clucasjiang/dexter_v1/(list of files, cad)

Other CAD files:
CAD/DexterAssembly.STEP
