clucasjiang/dexter_v1/PCB/main_controller/dexter_pcb.kicad_pcb

## KiCad design PCB/main_controller/dexter_pcb.kicad_pcb (2026-09-09)

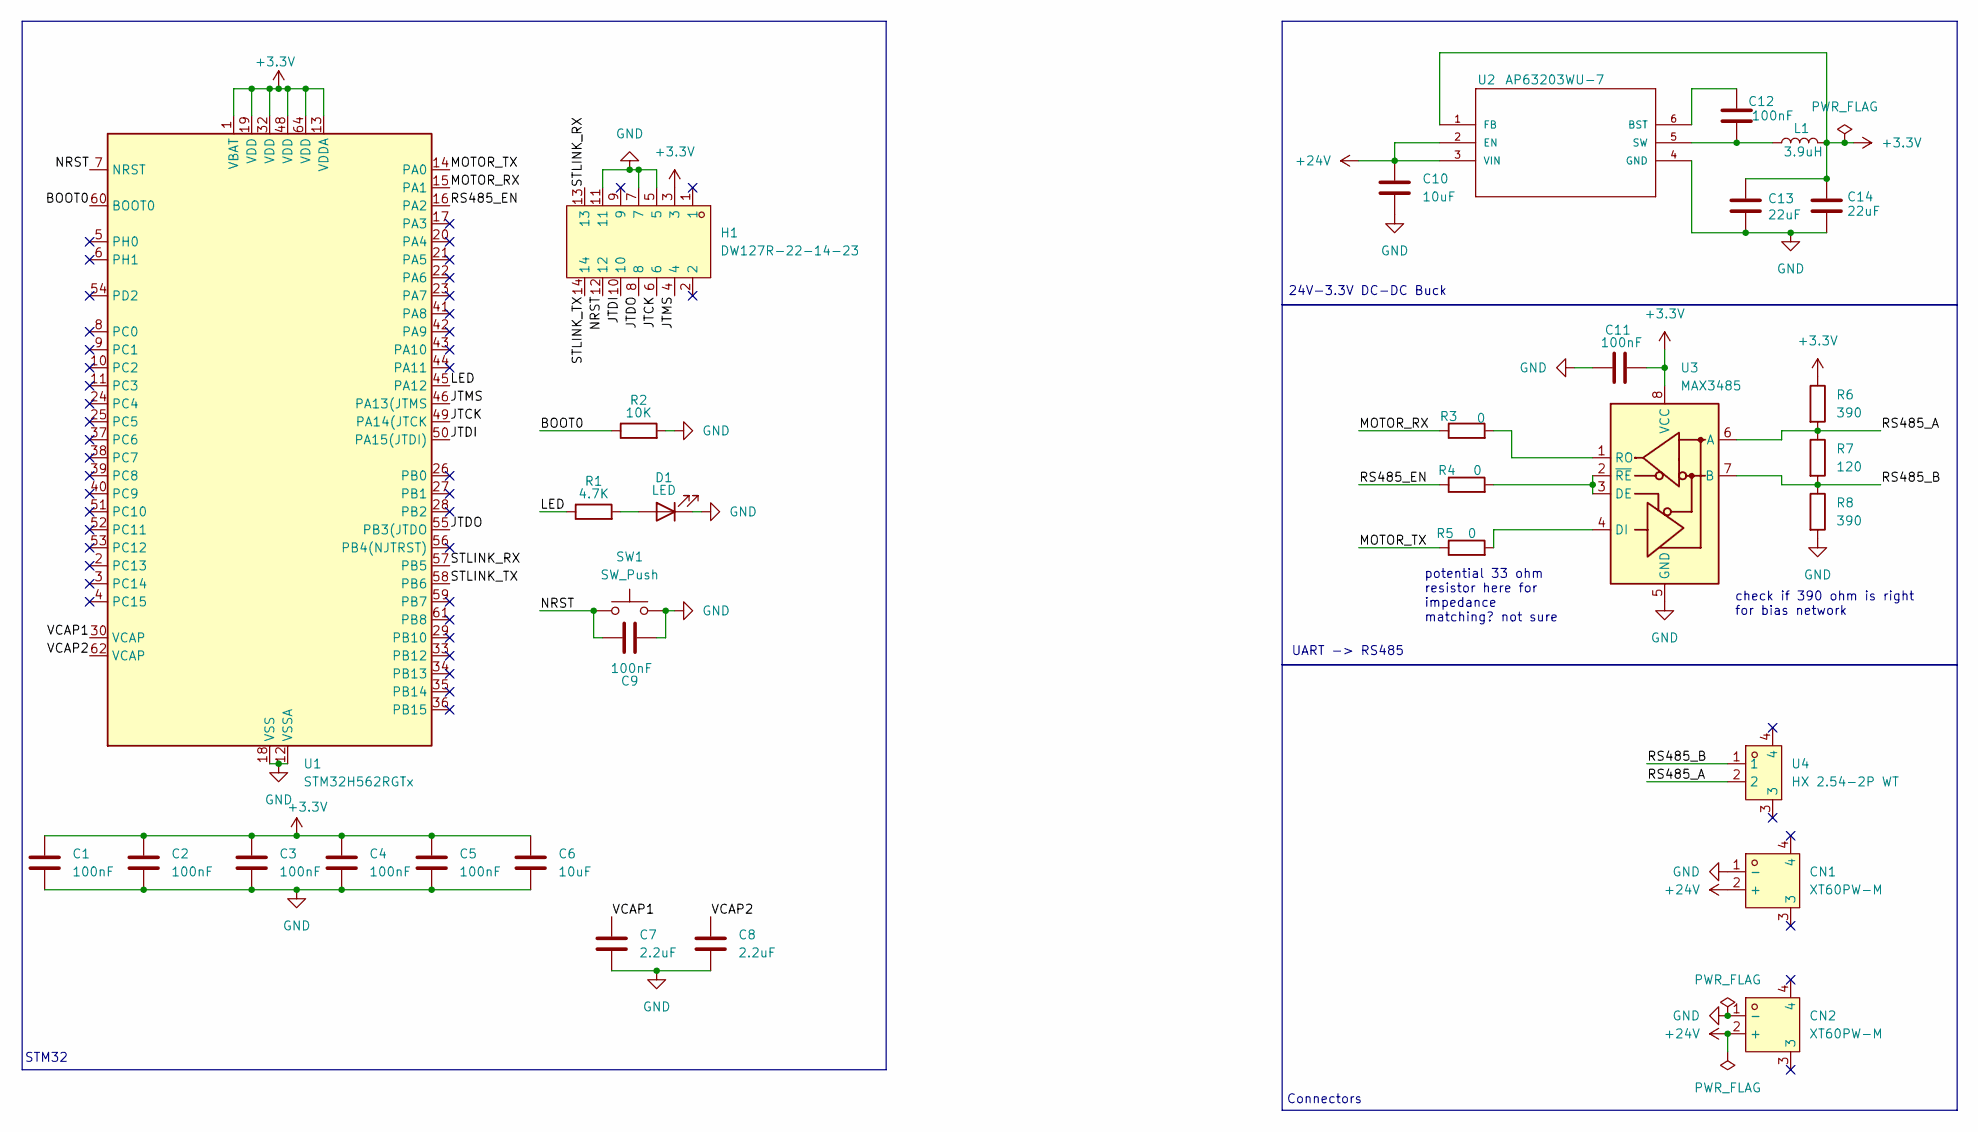
[picture p5: schematic dexter_pcb.kicad_sch, Dexter Main Controller]

Parts:
C1, C2, C3, C4, C5, C9, C11, C12: 100nF; C_0603_1608Metric_Pad1.08x0.95mm_HandSolder
C6, C10: 10uF; C_0603_1608Metric_Pad1.08x0.95mm_HandSolder
C7, C8: 2.2uF; C_0603_1608Metric_Pad1.08x0.95mm_HandSolder
C13, C14: 22uF; C_0603_1608Metric_Pad1.08x0.95mm_HandSolder
CN1, CN2: XT60PW-M; CONN-TH_XT60PW-M; MPN XT60PW-M; LCSC Part C98732
D1: LED; LED_0603_1608Metric_Pad1.05x0.95mm_HandSolder
H1: DW127R-22-14-23; HDR-TH_14P-P1.27-V-M-R2-C7-S1.27-2; MPN DW127R-22-14-23; LCSC Part C2935955
L1: 3.9uH; L_Changjiang_FNR4030S; LCSC C167872
R1: 4.7K; R_0603_1608Metric_Pad0.98x0.95mm_HandSolder
R2: 10K; R_0603_1608Metric_Pad0.98x0.95mm_HandSolder
R3, R4, R5: 0; R_0603_1608Metric_Pad0.98x0.95mm_HandSolder
R6, R8: 390; R_0603_1608Metric_Pad0.98x0.95mm_HandSolder
R7: 120; R_0603_1608Metric_Pad0.98x0.95mm_HandSolder
SW1: SW_Push; SW_SPST_TS-1088-xR020; LCSC C720477
U1: STM32H562RGTx; LQFP-64_10x10mm_P0.5mm; LCSC C19711662
U2: AP63203WU-7; TSOT-23-6_HandSoldering; MPN AP63203WU-7; LCSC C780769
U3: MAX3485; SOIC-8_3.9x4.9mm_P1.27mm; LCSC C9943
U4: HX 2.54-2P WT; CONN-SMD_2P-P2.54-XH2.54-WT; MPN HX 2.54-2P WT; LCSC Part C5142098

Connections:
+3.3V: C1.1, C2.1, C3.1, C4.1, C5.1, C6.1, C11.2, C13.1, C14.1, H1.3, L1.2, R6.1, U1.1 (VBAT), U1.13 (VDDA), U1.19 (VDD), U1.32 (VDD), U1.48 (VDD), U1.64 (VDD), U2.1 (FB), U3.8 (VCC)
+24V: C10.1, CN1.2 (+), CN2.2 (+), U2.2 (EN), U2.3 (VIN)
/BOOT0: R2.1, U1.60 (BOOT0)
/JTCK: H1.6, U1.49 (PA14(JTCK)
/JTDI: H1.10, U1.50 (PA15(JTDI))
/JTDO: H1.8, U1.55 (PB3(JTDO)
/JTMS: H1.4, U1.46 (PA13(JTMS)
/LED: R1.1, U1.45 (PA12)
/MOTOR_RX: R3.1, U1.15 (PA1)
/MOTOR_TX: R5.1, U1.14 (PA0)
/NRST: C9.1, H1.12, SW1.1, U1.7 (NRST)
/RS485_A: R6.2, R7.1, U3.6 (A), U4.2
/RS485_B: R7.2, R8.1, U3.7 (B), U4.1
/RS485_EN: R4.1, U1.16 (PA2)
/STLINK_RX: H1.13, U1.57 (PB5)
/STLINK_TX: H1.14, U1.58 (PB6)
/VCAP1: C7.1, U1.30 (VCAP)
/VCAP2: C8.1, U1.62 (VCAP)
GND: C1.2, C2.2, C3.2, C4.2, C5.2, C6.2, C7.2, C8.2, C9.2, C10.2, C11.1, C13.2, C14.2, CN1.1 (-), CN2.1 (-), D1.1 (K), H1.5, H1.7, H1.11, R2.2, R8.2, SW1.2, U1.12 (VSSA), U1.18 (VSS), U1.31 (VSS), U1.47 (VSS), U1.63 (VSS), U2.4 (GND), U3.5 (GND)
unnamed: D1.2 (A), R1.2
unnamed: C12.1, U2.6 (BST)
unnamed: C12.2, L1.1, U2.5 (SW)
unnamed: R4.2, U3.2 (~RE), U3.3 (DE)
unnamed: R5.2, U3.4 (DI)
unnamed: R3.2, U3.1 (RO)

Notes on the sheet:
UART -> RS485
24V-3.3V DC-DC Buck
STM32
Connectors
check if 390 ohm is right for bias network
potential 33 ohm resistor here for impedance matching? not sure

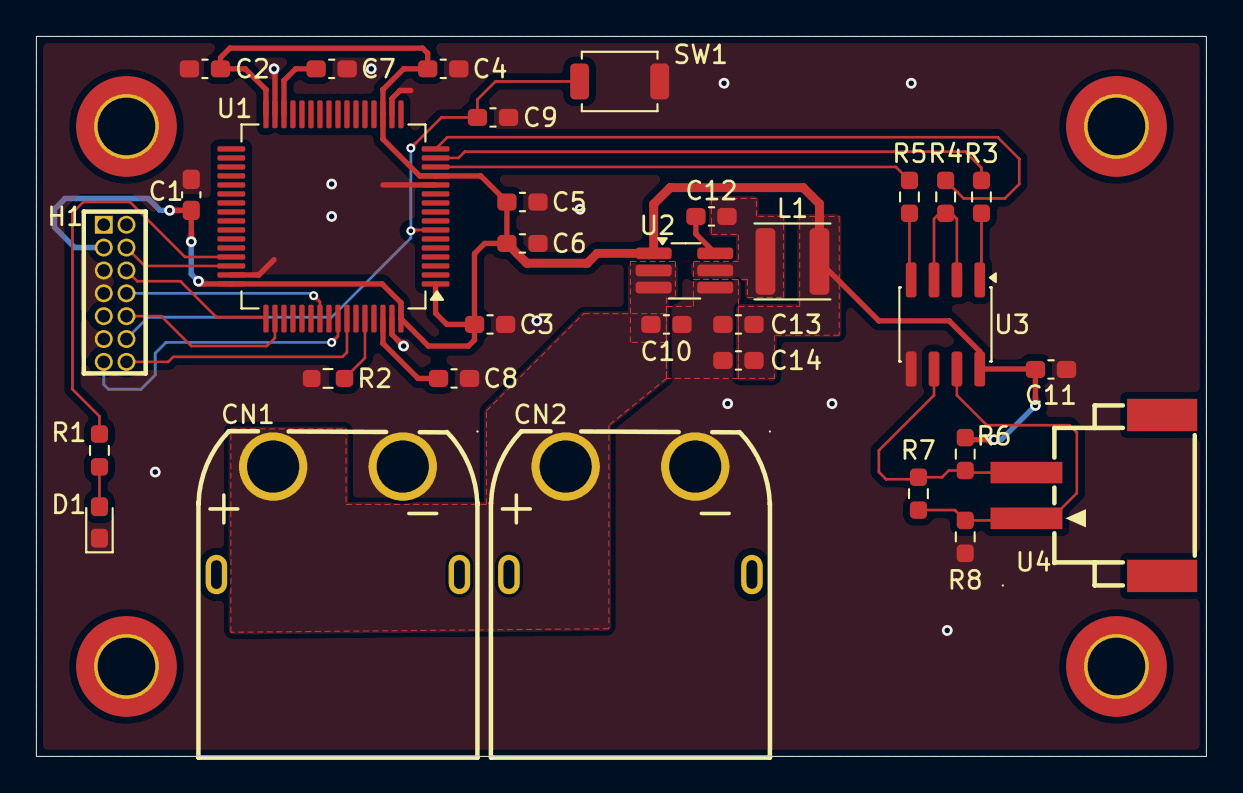
[picture p6: board dexter_pcb.kicad_pcb from above]

Board: 2 copper layers, 65.0 x 40.0 mm, 32 parts (0 on the bottom side), 25 nets.
